ImogenWren/single-tube-condenser-dev/README.md

# RL-single-tube-condenser
 Remote Labs Single Tube Condenser Experiment
