ImogenWren/single-tube-condenser-dev/documents/8605-pwm-proportional-valve-controller.PDF

Burkert UK Limited
Fluid Control Centre
1 Bridge End
Cirencester, GL7 1QY
e-mail: sales.uk@burkert.com

Bank details: HSBC UK Bank plc
GBP: Sort code 40-11-60, Acc. 81182129 IBAN : GB48 HBUK 4011 6081 1821 29 BIC : HBUKGB4194R
EUR: Sort code 40-12-76, Acc. 84484257 IBAN : GB08 HBUK 4012 7684 4842 57 BIC : HBUKGB4B

UK VAT Number: GB274130970 UK EORI Number: GB274130970000 NI EORI Number: XI274130970000 Registration Number: 831741

IE VAT & EORI Number: IE9952849G IE Registration Number: 909518

## Quotation

### University of Edinburgh School of Chemistry David Brewster Road Joseph Black Building Edinburgh Edinburgh, City of EH9 3FJ

### Burkert Contact:

### Account Administration

Tel.: | (01285) 64 87 20
Fax.: | (01285) 64 87 21
Mail: | sales.uk@burkert.com
Quotation No. | 3910054541
Date | 25.09.2023
Customer No. | 910001639

### Your Request Attn. Imogen Heard. from 25.09.2023

Customer mail: | a.m.r.hall@ed.ac.uk
Valid to: | 25.10.2023
Payment Terms: | Prepayment
Shipping Terms: | UK & N. Ireland
Delivery Terms (INCO 2010): | DAP / Named destination

Thank you for your enquiry, please find your quotation below.

Any dates or times stated in the quotation below are not binding or guaranteed. They are estimates only and are subject to change, which we will acknowledge accordingly.
Where a despatch is not shown for an item please contact our sales office
Item | Material | Material Description | Qty Unit | Price/Unit | Price
10 | 00316530 | Dig. control electroncis for prop.valves
| | 8605-H-PG-E-F-00-Q-B
| | | 1 PCE | 217.00 GBP | 217.00 GBP
Manual discount | 1 PCE | -25.00 % | -54.25 GBP
Net Value for Item | 1 PCE | 162.75 GBP | 162.75 GBP
Type | 8605 | 8605
Version of electronics | H | CABLE PLUG WITH OPERATING REV.2
Electrical connection | PG | terminal strip with cable screwing
Supply voltage | E | 24V DC
Control | F | 0-10V, 0-5V, 4-20mA, 0-20mA adjustable
Sensor Input | 00 | no indication
Output signal | Q | PMW-signal
Max. valve current | B | 200 - 1000 mA
T ambient min | -10
T ambient max | 60
Country of Origin: | Germany (Baden-Württemberg)
Commodity Code: | 90268020
Net weight / PCE | 0.150 KG
Estimated lead time: 4 to 5 weeks after order confirmation.

Quotation | Quotation No. | 3910054541
| Date | 25.09.2023
| Customer No. | 910001639

### Your Request Attn. Imogen Heard. from 25.09.2023

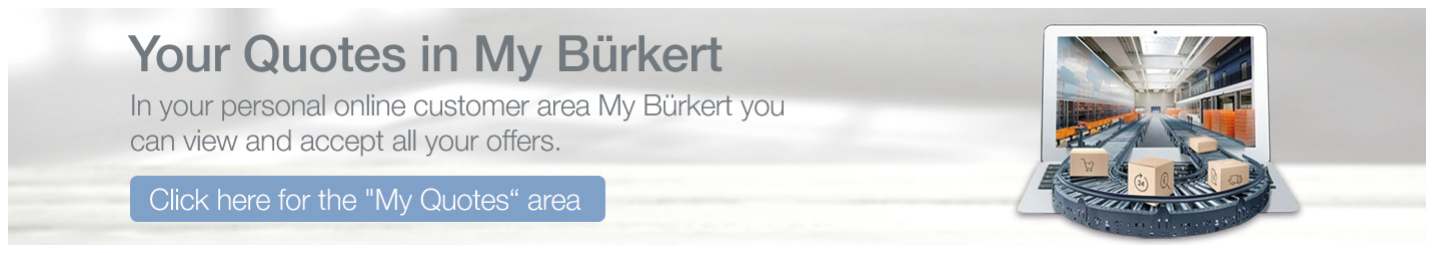
[picture p4: figure]
https://www.bu

Burkert UK Limited
Fluid Control Centre
1 Bridge End
Cirencester, GL7 1QY
e-mail: sales.uk@burkert.com

Bank details: HSBC UK Bank plc
GBP: Sort code 40-11-60, Acc. 81182129 IBAN : GB48 HBUK 4011 6081 1821 29 BIC : HBUKGB4194R
EUR: Sort code 40-12-76, Acc. 84484257 IBAN : GB08 HBUK 4012 7684 4842 57 BIC : HBUKGB4B

UK VAT Number: GB274130970 UK EORI Number: GB274130970000 NI EORI Number: XI274130970000 Registration Number: 831741

IE VAT & EORI Number: IE9952849G IE Registration Number: 909518

Freight & Packing | 15.00 GBP
Total net value | 177.75 GBP
excl. VAT

All delivery dates shown in this order confirmation are estimates only and may be subject to change. Wherever possible new order confirmations will be sent in the event of a change to the estimated delivery date.

Documentation/Certification
All documentation is supplied on request and if not already specified within our quotation may incur additional charges and may affect delivery times.

Freight & Packing
Freight & Packing charges are based on physical and volumetric shipment weight and include packaging materials.

Premium and Timed services are available on request

All proposals are subject to our standard Terms & Conditions of Sale, copies of which are available on request.

Please use our quotation number in all correspondence relating to this quotation.

To support your business needs Bürkert Fluid Control Systems offer complete customised solutions from design through engineering to commissioning and after sales service. Should this be of interest please contact us to arrange a professional consultation.

We hope that our offer is of interest and look forward to receiving your instruction to proceed. In the meantime, should you have any further questions then please do not hesitate to contact us.

Please note you can register and obtain tracking information at www.burkert.co.uk.

You can also find our EU declaration / declaration of conformity on our website by using the part code or range reference; www.burkert.com/ en

Kind Regards
Burkert UK Limited

http://www.burkert.com/feedback mailto:customer.feedback@burkert.com
fax number +49 (0) 79 40/10 154
Vince Webb | Your Regional Contact
Chris Hughes
Tel.: | (01285) 648733 | Tel.: | (1285) 648 720
| | Mobile: | 7385 3793 74
| | Fax.: | (1285) 6487 21
Mail: | vince.webb@burkert.com | Mail: | Chris.Hughes@burkert.com
