ImogenWren/single-tube-condenser-dev/documents/ADAM6052-quote.jpg

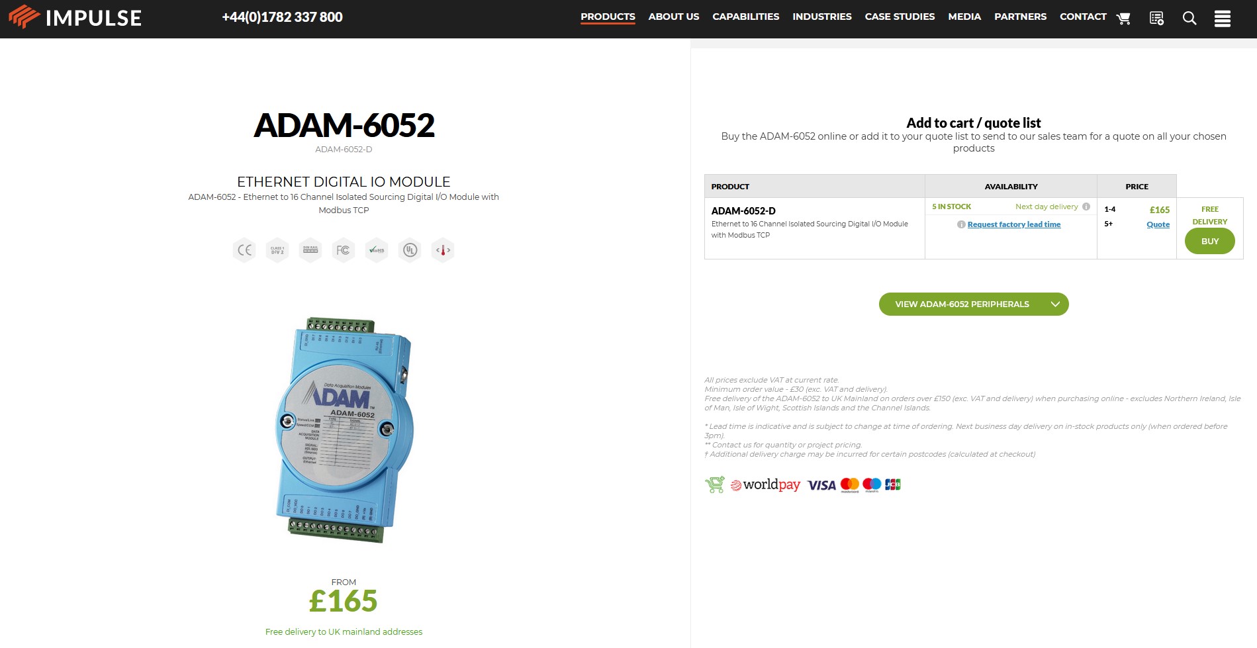
documents/ADAM6052-quote.jpg
