ImogenWren/single-tube-condenser-dev/documents/bme-280-sensor.jpg

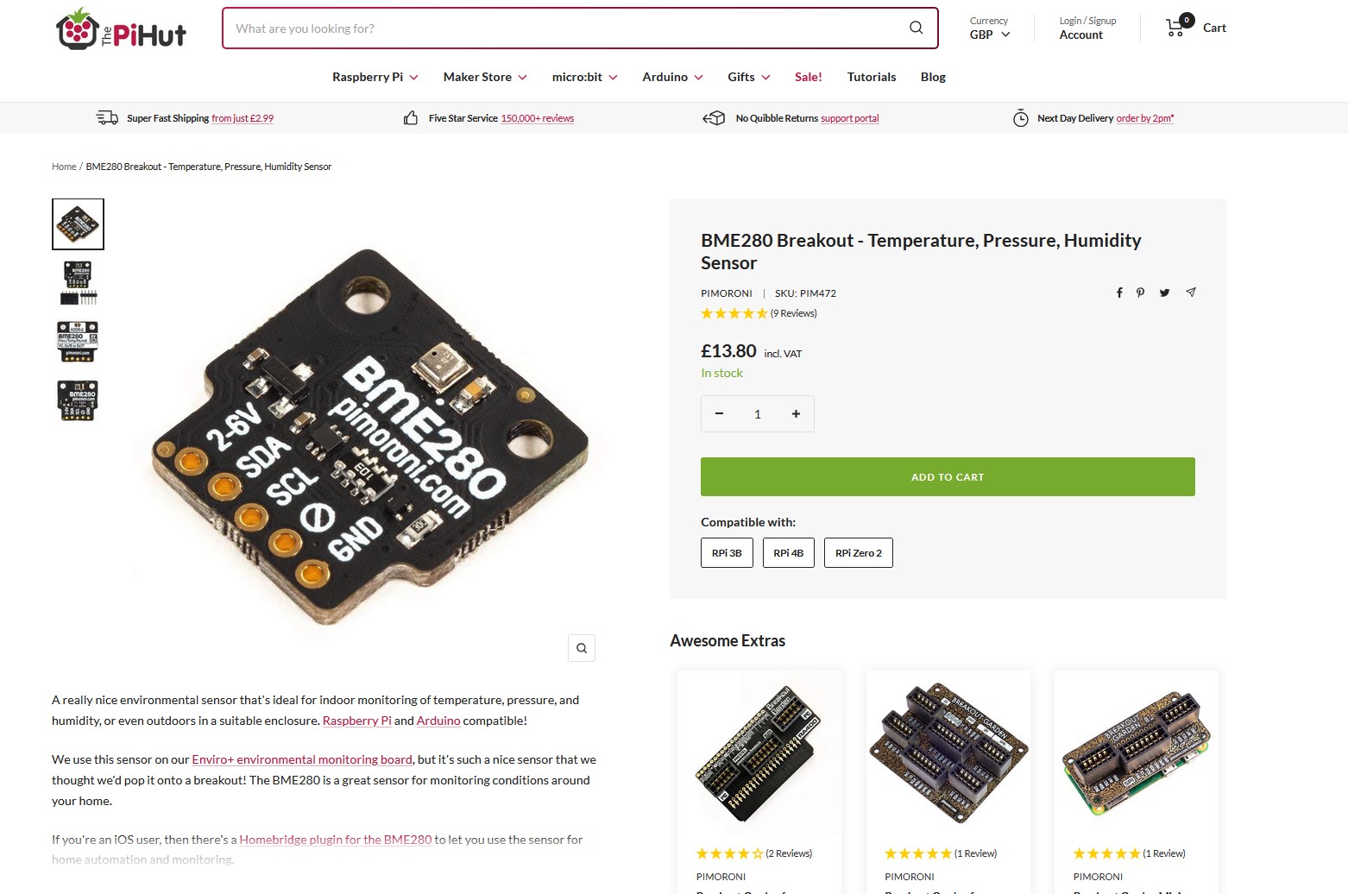
documents/bme-280-sensor.jpg
