ImogenWren/single-tube-condenser-dev/single-tube-condensor-schematic/dual-led-driver-circuit.jpg

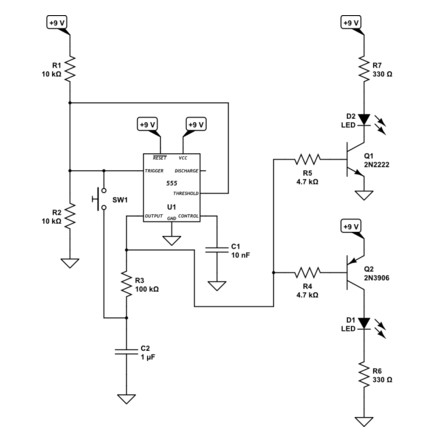
single-tube-condensor-schematic/dual-led-driver-circuit.jpg
