ImogenWren/single-tube-condenser-dev/documents/Single tube condensor - equipment needed.xlsx

Sheet: Schematic
Component | Description | Proposed control
V1 | Steam master on/off. | Technician controlled
R1 | Pressure regulator used to control steam volume to working fluid. | Technician controlled
M | Steam pressure gauge | Add pressure sensor - Gems?
V2 | Not used-always fully on. | NA
V3 | Used to throttle the steam to working fluid-adjusted by watching condensation on secondary condesnding coils (2-3 coils). | replace with Burkert motorised needle valve if necessary, ideally "set and forget"
V4 | Needle valve integrated on flow meter - used to control cooling on primary condensor. | leave fully open, add Enfield valve inline to control water flow, add RS digital flowmeter
V5 | Fully open - cooling unit turned on or off only. | Technician controlled, perhaps remote controll on chiller unit
V6 | Used to drain working fluid in conjunction with V8. | Technician controlled
V7 | Used to dry rig between working fluid changes in conjunction with V8. | Technician controlled
V8 | Used with V6 and V7 above. | Technician controlled
TIN | Primary condensor inlet water temp. | Tap into thermocouple signal
TOUT | Primary condensor outlet water temp. | Tap into thermocouple signal
TV | Primary condensor environment temperature | Tap into thermocouple signal
TL | Working fluid temperature | Tap into thermocouple signal

Sheet: System IOs
 | Part required | Manufacturer | Mfr P.N. | Price (£) | Price € | Qty Rq'd | Total | Control/Indicator | Control/Signal Type | Signal Range | Notes |  | Additional info | Supplier | Delivery time | Link
 | Water flow meter | RS | 257-149 | £55.92 |  | 1 | £55.92 | indicator | Pulse | 4.5-16 VDC | Assume Vout = Vin |  | For digital output of cold water flow | RS | in stock | https://uk.rs-online.com/web/p/flow-sensors/0257149
 | Motorised needle valve | Enfield | ENV-0670 | £470.00 |  | 1 | £470.00 | control | Driver Board (see below) |  |  |  | For controlling cold water flow 577usd | Enfield | in stock | https://www.enfieldtech.com/Products/ENV-2-2-MOTORIZED-NEEDLE-VALVES/ENV-0670-Motorized-Needle-Valve
 | Driver for valve | Enfield | D5-05-U01 | £180.00 |  | 1 | £180.00 | control | Analog Voltage | 0-10v |  |  | As above 220USD | Enfield | in stock | https://www.enfieldtech.com/Products/ENV-2-2-MOTORIZED-NEEDLE-VALVES/D5-05-U01
 | Pressure sensor | Gems |  |  |  | 1 |  | control | Analog Voltage? | 0-10v? |  |  | emailed Gems for advice 31/5/23 | Gems sensors |  | https://www.gemssensors.co.uk/
 | Proportional steam valve | Burkert | 375565 | 3716 |  | 1 | £3716.00 |  |  |  |  |  | provisional quote based on rough estimate of required flow rate | Burkert | 9-10 weeks | https://www.burkert.co.uk/en
 |  |  |  |  |  | Total | £4421.92
 |  |  |  |  |  | 20% | £5306.30 |  |  |  |  |  | Additional info | Supplier | Delivery time | Link
 | Parts required - ELECTRIC HEATING | Manufacturer | Mfr P.N. | Price |  | Qty Rq'd | Total |  |  |  |  |  | For digital output of cold water flow | RS | in stock | https://uk.rs-online.com/web/p/flow-sensors/0257149
 | Cold Water flow meter | RS | 257-149 | £55.92 |  | 1 | £55.92 | indicator | Pulse | 4.5-16 VDC | Assume Vout = Vin |  | For controlling cold water flow 577usd | Enfield | in stock | https://www.enfieldtech.com/Products/ENV-2-2-MOTORIZED-NEEDLE-VALVES/ENV-0670-Motorized-Needle-Valve
 | Motorised needle valve | Enfield | ENV-0670 | £470.00 |  | 1 | £470.00 | control | Driver Board (see below) |  |  |  | As above 220USD | Enfield | in stock | https://www.enfieldtech.com/Products/ENV-2-2-MOTORIZED-NEEDLE-VALVES/D5-05-U01
 | Driver for valve | Enfield | D5-05-U01 | £180.00 |  | 1 | £180.00 | control | Analog Voltage | 0-10v
 | Heating Element |  |  | £300.00 |  | 1 | £300.00 | control | Relay?
 |  |  |  |  |  | Total | £1005.92
 |  |  |  |  |  | 20% | £1207.10
Requirement | Electronic Equipment Specified | Manufacturer | Mfr P.N. | Price |  | Qty Rq'd | Total | Control/Indicator | Control/Signal Type | Signal Range |  |  | Additional info | Supplier | Delivery time | Link
Cold Water flow meter | ADAM-5080 | Advantech | ADAM-5080 | £320.00 | ESTIMATED | 1 | £320.00 | Indicator | Pulse | 5v TTL |  |  |  | Advantech |  | https://www.advantech.com/th-th/products/a85377de-9600-4649-a0d6-b0c84ef3202d/adam-5080/mod_95ed1d56-38b2-4ac7-86d1-63abfed56e2c
 | 4-ch Counter/Frequency Module |  | "get quote"
Needle Valve Driver | ADAM-5024-A2E | Advantech | ADAM-5024-A2E |  | €327.70 | 1 | £327.70 | Control | Analog Voltage/Current | 0-10V (+ 0-20mA) |  |  |  | Advantech Online | "Available for Delivery" | https://buy.advantech.eu/I-O-Devices-Communication/Remote-I-O-Modules-ADAM-I-O-Modules/model-ADAM-5024-A2E.htm
Heating Element Relay | ADAM-5056D-AE | Advantech | ADAM-5056D-AE |  | €105.20 | 1 | £105.20 | Control | Digital | Open Collector to 30v |  |  |  | Advantech Online | "contact for stock" | https://buy.advantech.eu/I-O-Devices-Communication/Remote-I-O-Modules-ADAM-I-O-Modules/model-ADAM-5056D-AE.htm
 | AND |  |  |  |  |  |  |  |  | 100mA max
Heating Element Relay | Finder DIN Rail Mount Interface Relay, 12V dc Coil, 16A Load Current, SPDT | Finder | 48.P6.7.012.0050SPA | £13.14 |  | 1 | £13.14 | Control | Relay | 240v switching 16A load |  |  |  | RS online | in stock | https://uk.rs-online.com/web/p/electromechanical-interface-relays/1232816?gb=s
 |  |  |  |  |  |  |  |  |  | 12v coil
DAQ Chassis | ADAM 4 Slot Ethernet |  |  |  | €398.00 | 1 | £398.00 |  |  | 10-30v |  |  |  | Advantech |  | https://buy.advantech.eu/I-O-Devices-Communication/Remote-I-O-Modules-ADAM-Controllers/model-ADAM-5000L/TCP-BE.htm
 | ADAM-5000 DAQ Chassis |  |  |  |  |  |  |  |  |  |  |  |  | Impulse-Embedded |  | https://www.impulse-embedded.co.uk/products/adam_5000l~tcp--Distributed-DAQ-system.htm
PSU | RS PRO DIN Rail Power Supply, 85 → 264 V ac, 120 → 370 V dc ac, dc Input, 12V dc Output, 10A Output, 120W |  |  | £86.28 |  | 1 | £86.28 |  |  |  |  |  |  | RS | in stock | https://uk.rs-online.com/web/p/din-rail-power-supplies/2205404?gb=s
Enclosure |  |  |  |  |  | 1 | £150.00
Sunds Electronics (terminals etc) |  |  |  |  |  | 1 | £150.00
 |  |  |  |  |  |  |  |  |  | Electric |  | Steam
 |  |  |  |  | Electronics |  |  |  | Total Total | £3067.49 |  | £7166.69
 |  |  |  |  | Total |  | £1550.32
 |  |  |  |  | 20% |  | £1860.38

Sheet: Mechanical parts
Part required | Manufacturer | Mfr P.N. | Price | Supplier | Qty Rq'd | Total | Delivery time | Link | Additional info
Water flow meter | RS | 257-149 | £55.92 | RS | 1 | £55.92 | in stock | https://uk.rs-online.com/web/p/flow-sensors/0257149 | For digital output of cold water flow
Motorised needle valve | Enfield | ENV-0670 | £470.00 | Enfield | 1 | £470.00 | in stock | https://www.enfieldtech.com/Products/ENV-2-2-MOTORIZED-NEEDLE-VALVES/ENV-0670-Motorized-Needle-Valve | For controlling cold water flow 577usd
Driver for valve | Enfield | D5-05-U01 | £180.00 | Enfield | 1 | £180.00 | in stock | https://www.enfieldtech.com/Products/ENV-2-2-MOTORIZED-NEEDLE-VALVES/D5-05-U01 | As above 220USD
Pressure sensor | Gems |  |  | Gems sensors | 1 |  |  | https://www.gemssensors.co.uk/ | emailed Gems for advice 31/5/23
Proportional steam valve | Burkert | 375565 | 3716 | Burkert | 1 | £3716.00 | 9-10 weeks | https://www.burkert.co.uk/en | provisional quote based on rough estimate of required flow rate
Parts required - ELECTRIC HEATING | Manufacturer | Mfr P.N. | Price | Supplier | Qty Rq'd | Total | Delivery time | Link | Additional info
Cold Water flow meter | RS | 257-149 | £55.92 | RS | 1 | £55.92 | in stock | https://uk.rs-online.com/web/p/flow-sensors/0257149 | For digital output of cold water flow
Motorised needle valve | Enfield | ENV-0670 | £470.00 | Enfield | 1 | £470.00 | in stock | https://www.enfieldtech.com/Products/ENV-2-2-MOTORIZED-NEEDLE-VALVES/ENV-0670-Motorized-Needle-Valve | For controlling cold water flow 577usd
Driver for valve | Enfield | D5-05-U01 | £180.00 | Enfield | 1 | £180.00 | in stock | https://www.enfieldtech.com/Products/ENV-2-2-MOTORIZED-NEEDLE-VALVES/D5-05-U01 | As above 220USD
