ImogenWren/single-tube-condenser-dev/single-tube-condensor-schematic/single-tube-condensor-schematic-V1.0.1pdf.pdf

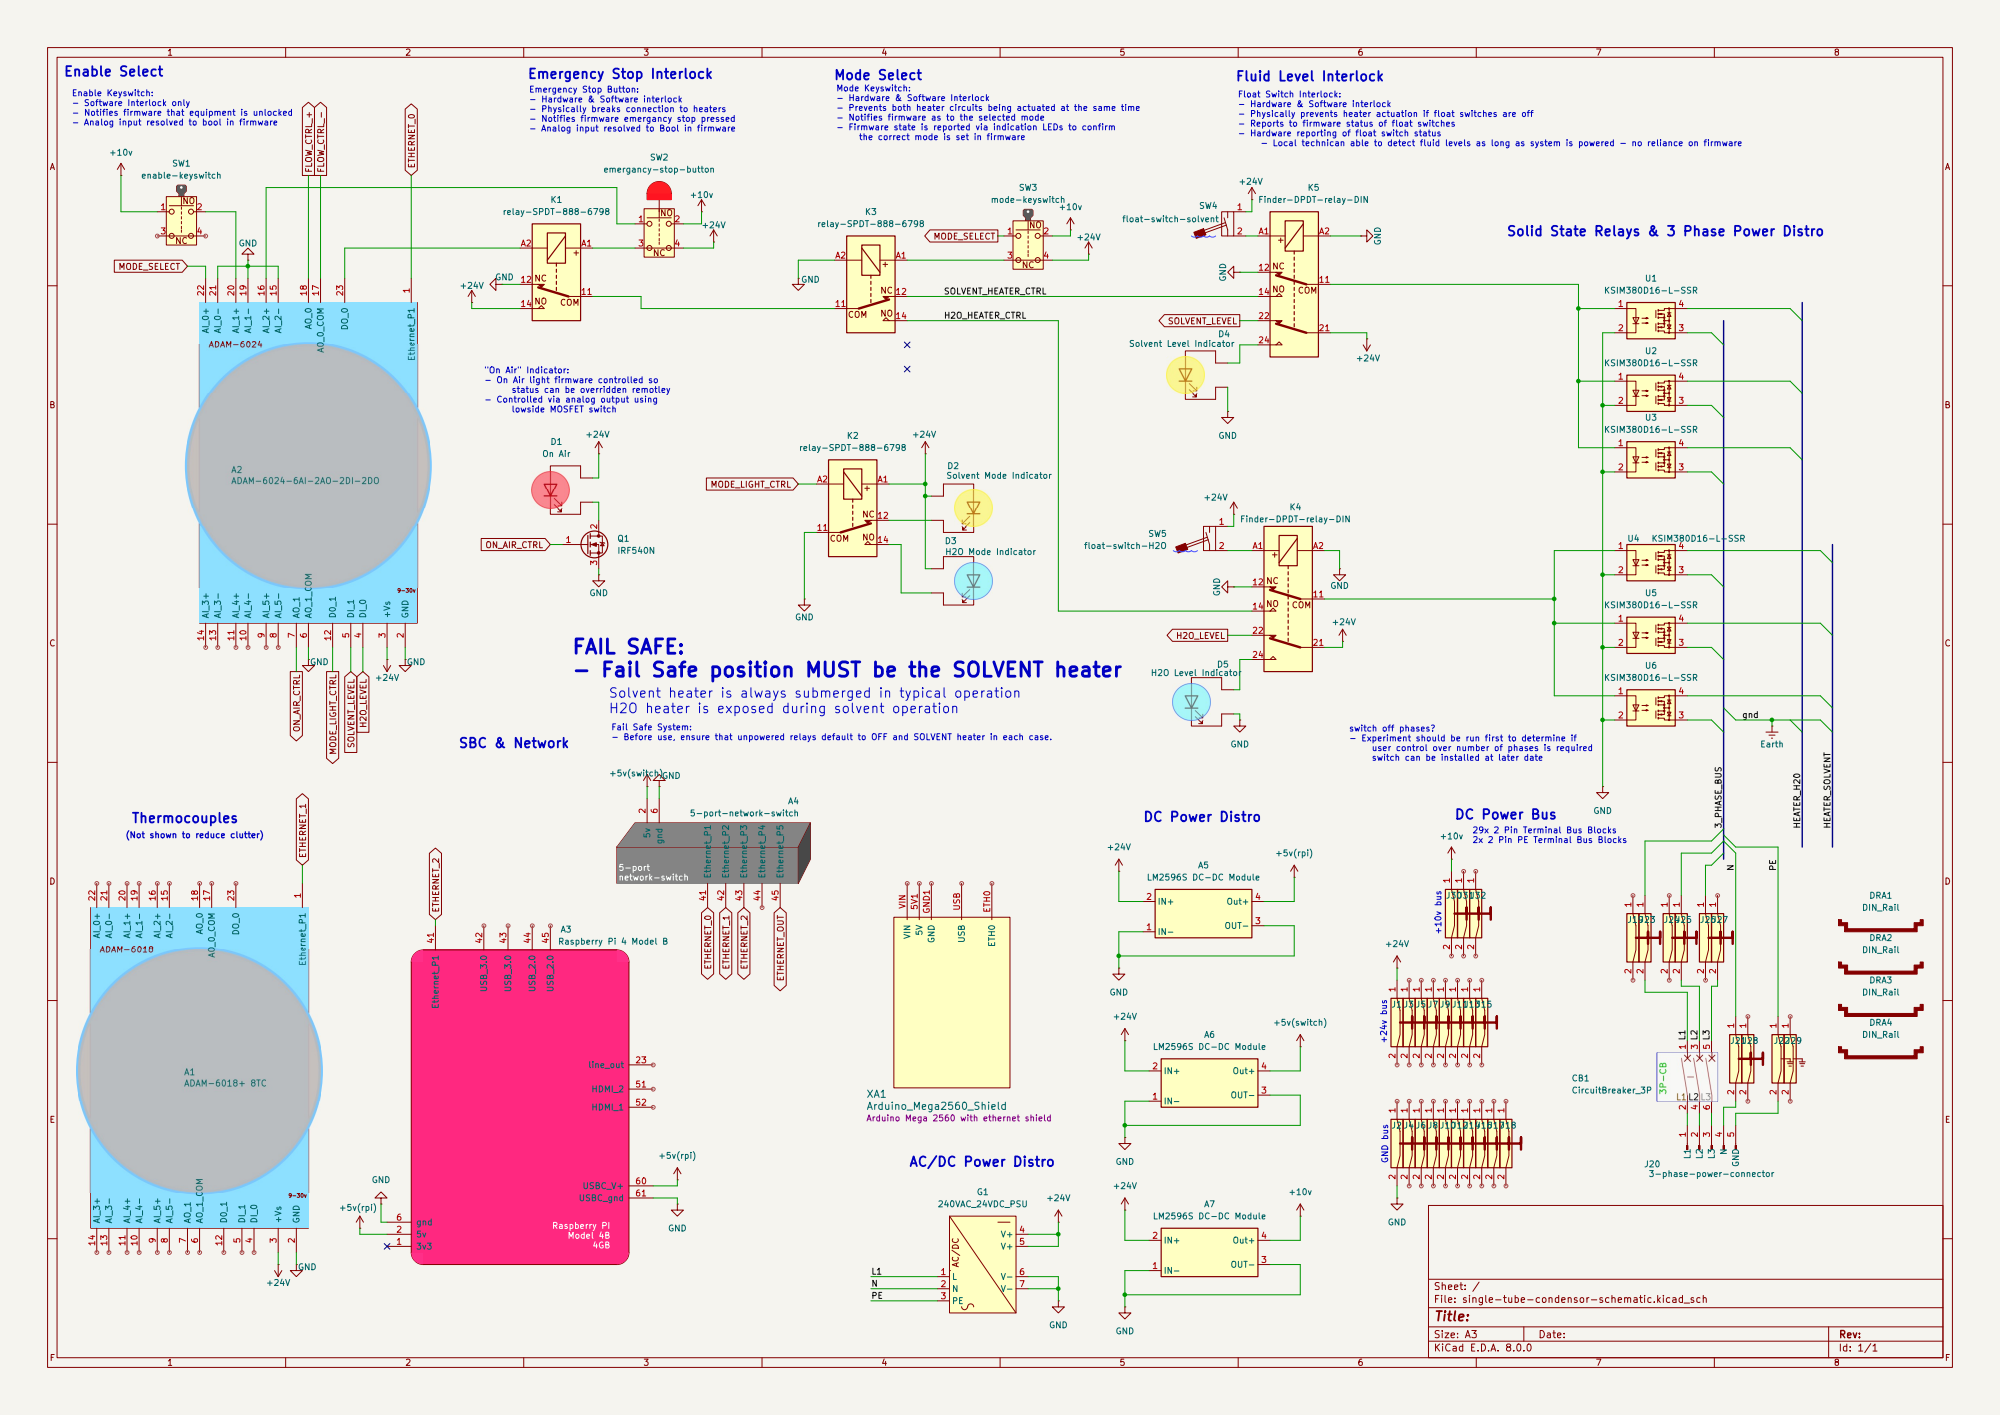
[picture p10: page 1]
