ImogenWren/single-tube-condenser-dev/single-tube-condensor-schematic/single-tube-condensor-schematic-V1.0.pdf

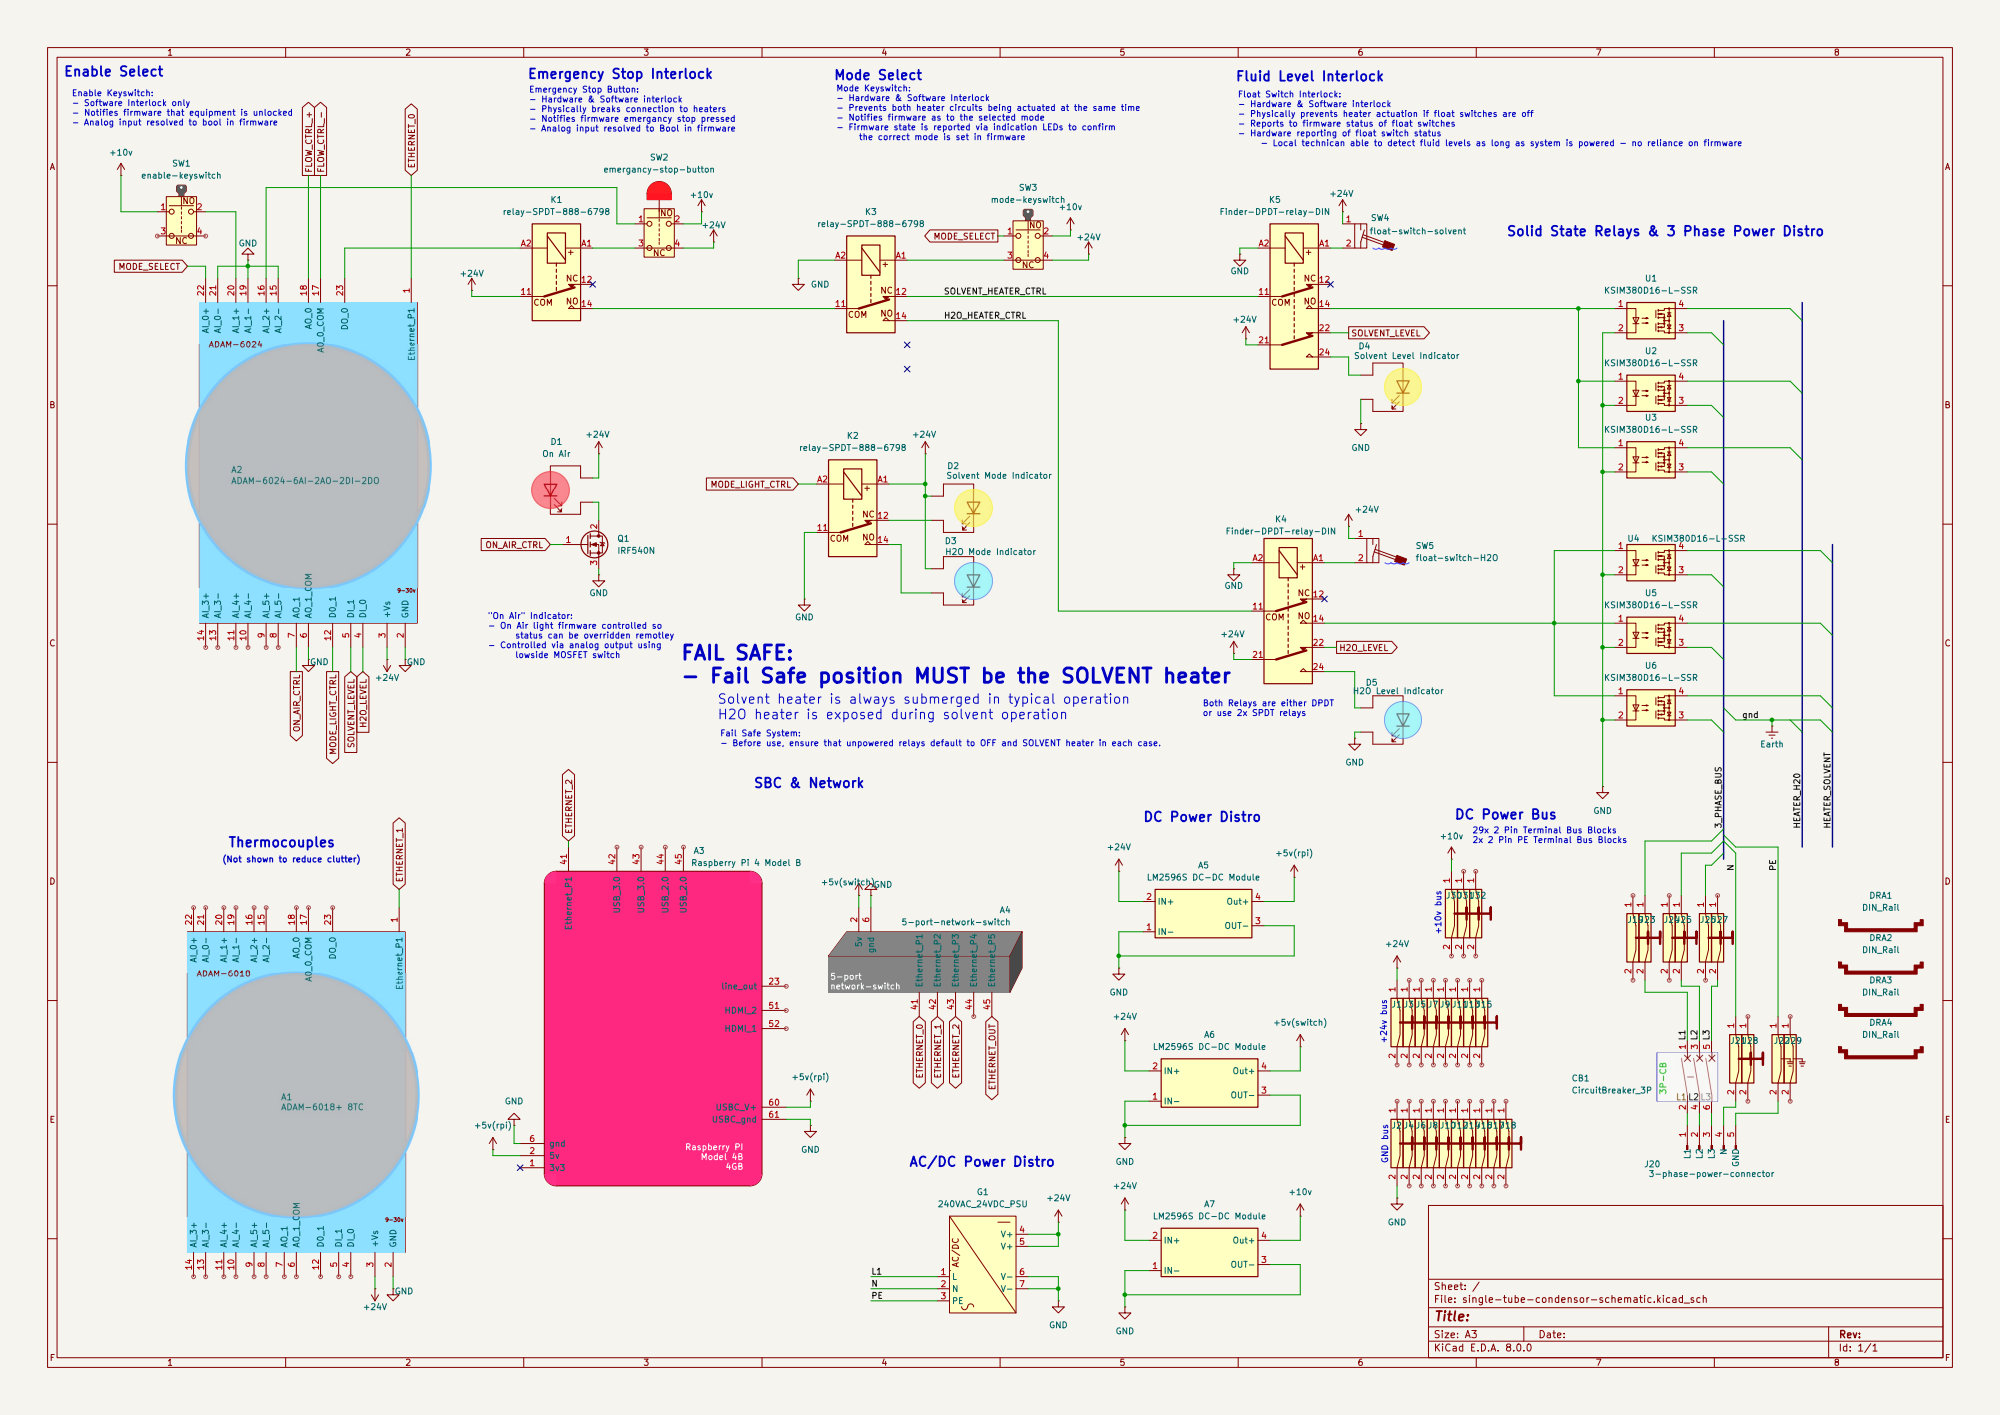
[picture p11: page 1]
