ImogenWren/single-tube-condenser-dev/datasheets/heater-wiring.pdf

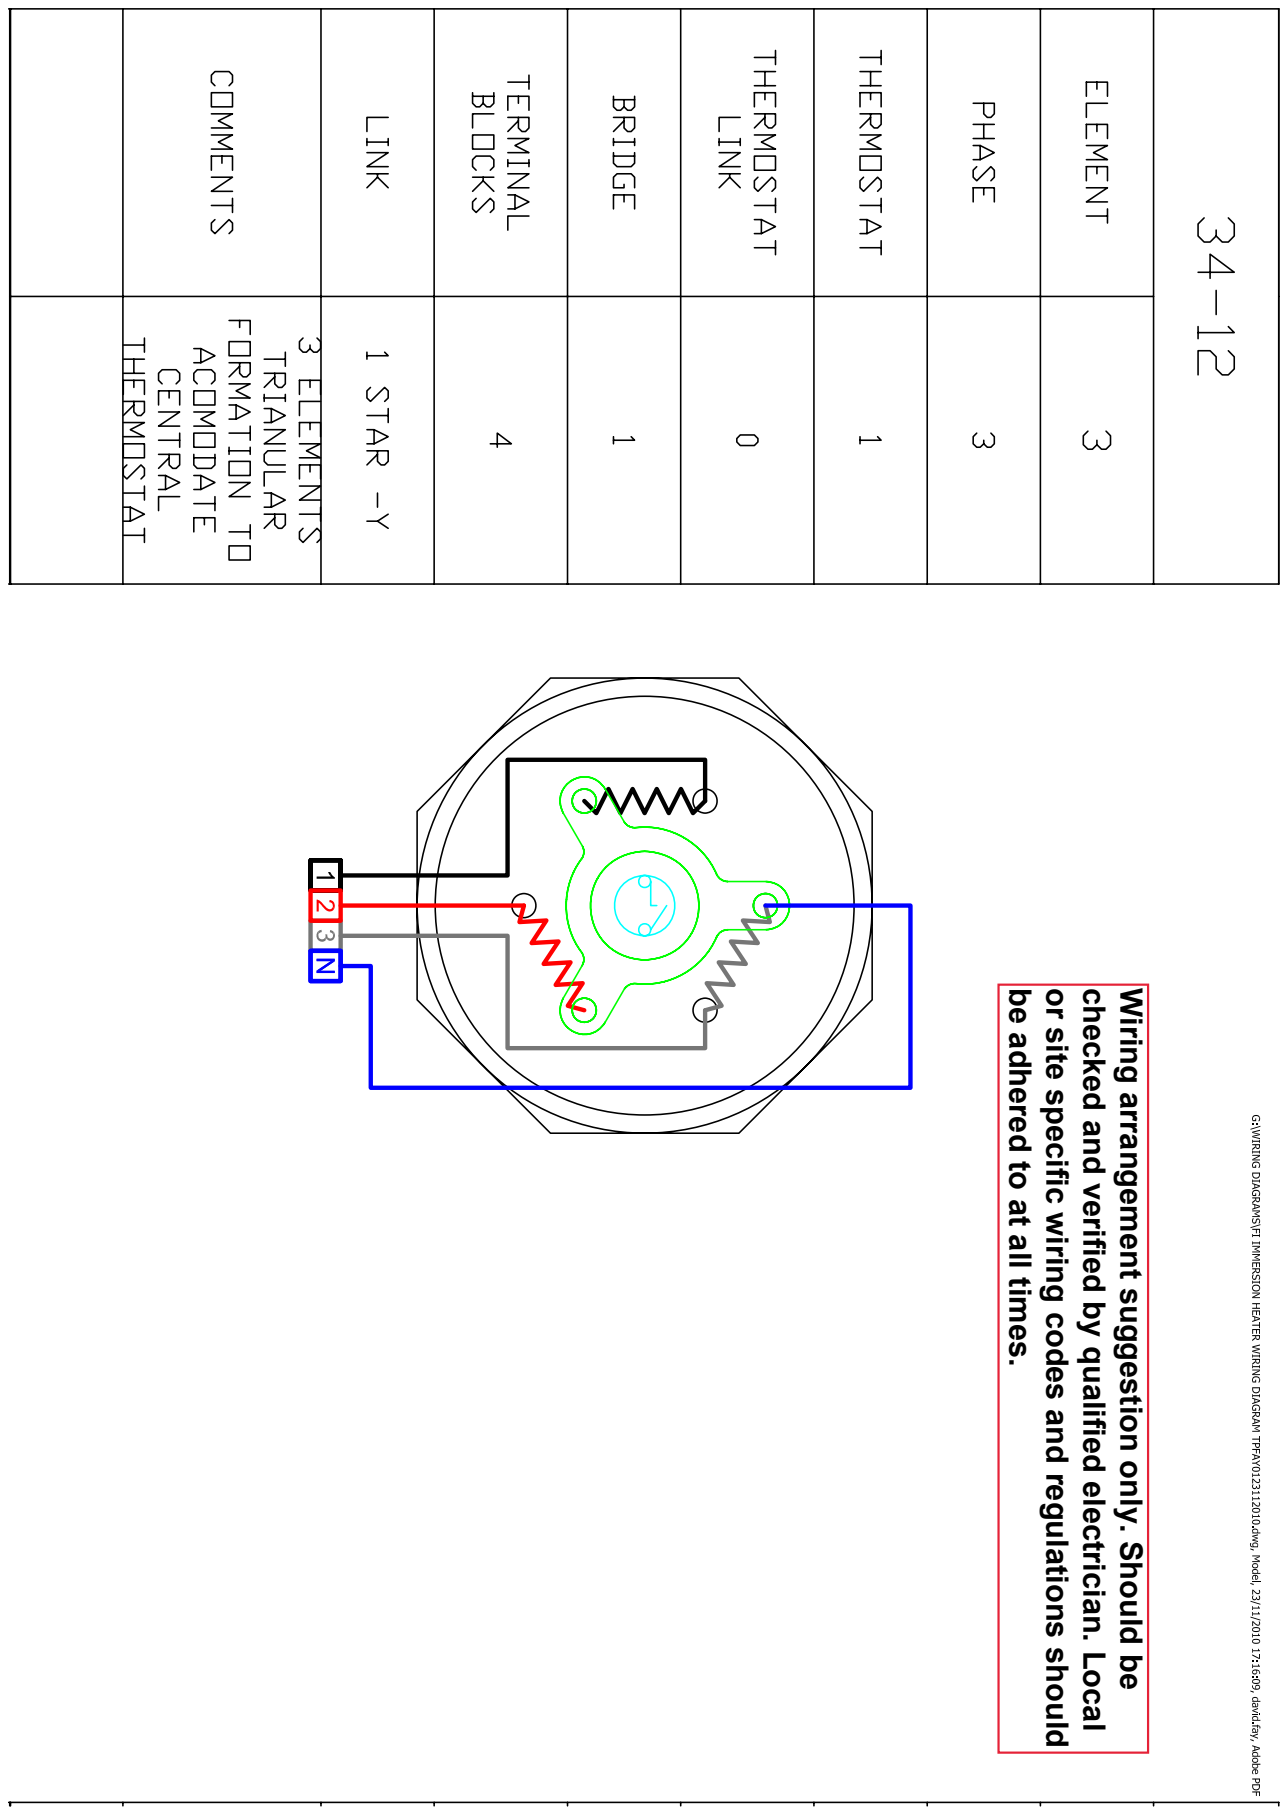
[picture p12: page 1]
