ImogenWren/single-tube-condenser-dev/(commit log)

2024-02-02 organised files
    [Single tube condensor - equipment needed.xlsx]
2024-03-05 started schematic & added documentation
    [single-tube-condensor-schematic.kicad_pcb, single-tube-condensor-schematic.kicad_sch]
2024-03-05 schem updates
    [single-tube-condensor-schematic.kicad_sch]
2024-03-06 schem almost done
    [single-tube-condensor-schematic.kicad_sch]
2024-03-07 finished V0.9 schematic
    [single-tube-condensor-schematic.kicad_sch]
2024-03-07 todo fix the LED indicator on a single current sink pin
    [single-tube-condensor-schematic.kicad_sch]
2024-03-08 finished V1.0 schematic
    [single-tube-condensor-schematic.kicad_sch]
2024-03-12 modified to show NC and NO relay connections
    [single-tube-condensor-schematic.kicad_sch]
2024-03-12 working on CAD layout
    [single-tube-condensor-schematic.kicad_pcb, single-tube-condensor-schematic.kicad_sch]
2024-03-12 uopdated schematioc
    [single-tube-condensor-schematic.kicad_pcb, single-tube-condensor-schematic.kicad_sch]
2024-03-14 big changes
    [single-tube-condensor-schematic.kicad_pcb]
2024-03-15 finished schematic
    [power-supply-calculator.xlsm, single-tube-condensor-schematic.kicad_pcb, single-tube-condensor-schematic.kicad_sch]
2024-03-29 updated schematic & box layout
    [single-tube-condensor-schematic.kicad_pcb, single-tube-condensor-schematic.kicad_sch]
